davidpalma666/FED3-tester-FORK/PCB/FED3 tester.txt

OEPS020129	SMD 0603 48.7Ω ±1% 0.100W
OEPS020221	SMD 0805 0.5Ω ±1% 0.333W 

* * * * * * * * * * * * * * * * * * * * * * * * * * * * * * * * * * * * * * * * * * * * * * * * * * * * * * * * * * * * 
*  @6 Julho 2026

- novo OPAMP ZXCT199xA2	G=100
simulações feitas em Spice

Vload=3.7V
Iload=100uA => medir corrente em valor ADC <1.1V
Iload= 8.80mA => medir corrente em valor ADC <1.1V
Iload=500mA => FED3 em trabalho normal(?); não necessário medir corrente; garantir execuibilidade com este OPAMP

valor MáxADC=1.1V => apontar os dois valores a medir para meio escala ~500mV

Iload=100uA	=> Rsample=45R	=> Rload= 40k	 => Vout2ADC=500mv	OK		P(Rsample)=570nW escolher case

Iload=8.8ma => Rsample=0.6R => 	Rload= 420.5R	=> Vout2ADC=46uW		OK

Iload=500mA => Rload=6R			=> @ trabalhar com a Rsample=0.6R & Iload=500mA 	=> P(6R)= 188mW  escolher case => 
							Vout2ADC=3.3V saturado pela tensão alimentação	OK

* * * * * * * * * * * * * * * * * * * * * * * * * * * * * * * * * * * * * * * * * * * * * * * * * * * * * * * * * * * * 
*  @18 Junho 2026

Feitos testes centrados em Imeasure & modificados valores & topologia de circuito

- Rmeasure passou de 0.5R a 1R
- R36;37 alterado valor para garantir mais Iin em U9; novo valor 400R
- R47: corrigido valor de R47 para maior Vout qd Itest=8.8mA; novo valor 24k
- modificada topologia de ligação U9 Imeasure para com Relay K3
- R LDO U4 para 3.7V: corrigida R7

>> pontos acima modificados na board mas ainda não na BOM
- corrigir valores e gerar nova BOM
- ainda não modificar PCB

>> para Imeasure:
- Current measure U9=ZXCT1082 difícil para garantir medidas de corrente Imin=100uA a Imax=8.8mA
- solução em vista: utilizar novo I measure ZXCT199A3DW
- Filipe disse q por agora garantir a medição precisa dos 8.8mA será o mais importante

>> neste passo do projecto garantir a medição @8.8mA com precisão
- num novo passo testar & implementar novo ZXCT199A3DW... talvez

>> ToDo a seguir:
>> preparar & certificar o OK da board para passar ao Filipe para fw dvlpm
>> rever Rs alteradas - algumas terá de haver novo OEPSPN
>> prepar/procurar nova board para testes de ZXCT199A3DW

* * * * * * * * * * * * * * * * * * * * * * * * * * * * * * * * * * * * * * * * * * * * * * * * * * * * * * * * * * * * 
*  @24 Abril 2026
- sobre rev.B
	. pinout dos relais mal desenhado
	. R de buzzer muito grande; Rbuzzer=1r
	
- início de redesenho: FAB3 tester - rev.C

- pontos acima redesenhados e commited em Github

* * * * * * * * * * * * * * * * * * * * * * * * * * * * * * * * * * * * * * * * * * * * * * * * * * * * * * * * * * * * 
*  @11 Fevereiro 2026
>>espaçadores
	https://pt.farnell.com/harwin/r30-1611200/standoff-nylon-6-6-hex-f-f-m3/dp/3755692
	https://pt.farnell.com/harwin/r30-1611300/standoff-nylon-6-6-hex-f-f-m3/dp/3755693
	https://pt.farnell.com/harwin/r30-1611200/standoff-nylon-6-6-hex-f-f-m3/dp/3755692

* * * * * * * * * * * * * * * * * * * * * * * * * * * * * * * * * * * * * * * * * * * * * * * * * * * * * * * * * * * * 
*  @16 Fevereiro 2026

- opções para pilares de Nylon 
	. entre as board FED3 tester- support & FED3 tester
	. pilares necessários de 13mm
	. refª Buuzzer: SMT-0540-S-R	Digikey: 668-1060-6-ND
	
headers ON FED3:
	1x2	OEPS070079		68001-202HLF
	1x5	OEPS070131		M20-9990546

sockets on FED3 tester
	1x2	socket
			https://www.digikey.com/en/products/detail/sullins-connector-solutions/PPTC021LFBN-RC/810142
			MPN:	PPTC021LFBN-RC
			Dgk:		S7000-ND

	1x5 female socket
		https://www.digikey.com/en/products/detail/sullins-connector-solutions/PPTC051LFBN-RC/807239
			MPN:	PPTC051LFBN-RC
			Dgk:		S6103-ND
	
	1x5 90ºmale
		https://www.digikey.com/en/products/detail/sullins-connector-solutions/PPPC051LGBN-RC/775938
		MPN:	PPPC051LGBN-RC
		Dgk:	S5480-ND

* * * * * * * * * * * * * * * * * * * * * * * * * * * * * * * * * * * * * * * * * * * * * * * * * * * * * * * * * * * * 
*  @4 Fevereiro 2026
- placas para teste a produzir
- ainda sem componentes - para avaliar inteegração mecânica

* * * * * * * * * * * * * * * * * * * * * * * * * * * * * * * * * * * * * * * * * * * * * * * * * * * * * * * * * * * * 
*  @30 Janeiro 2026

>> nova topologia para TP na placa redesenhada pelo Filipe:
	GND - Connect to GND

	ADCx - Connect to any ADC of the uC (PORTA)
		VCCRGB
		3V3
		LED-Charge
		RED_LED
		GREEN_LED
		
	D0 - Connect to any uC pin with a 1k resistor in series
		Enable
		
	D1 - Connect to any uC pin with a 1k resistor in series
			\Reset
			
	A0 - Needs a relay to switch between open and power deliver (using the 3.7V LDO with current meter *) to DUT. Also connect to any uC's ADC (PORTA). * The power meter (or two power meters) should be able to read from 0 to 1 mA and from 20 to 300 mA.
		VBat

	A1 - Power deliver directly to DUT from the USB 5V with a power meter in the way (up to 300 mA). Needs a relay to turn the power off
		VUSB

	PROG - Direct connection to programmer

	MOTOR - Direct connection to motor
	
	RELAY - Connected to a relay to Open/Close the connection between the pins

* * * * * * * * * * * * * * * * * * * * * * * * * * * * * * * * * * * * * * * * * * * * * * * * * * * * * * * * * * * * 
*  @29 Janeiro 2026

>> Revisões feitas com o Filipe
	. agulha/ponto para Enb/Dsb do Main Switch (??)
	. agulha/ponto para ler estado dos LEDs - esperar por decisão
	
	. leitura I:
		. I min agora é 800uA; próximo volume será 80uA
		. IMax 8mA
		. em causa o q está feito com ZXCT1082
			. RLoad tem q ser grande
			. foi dimensionado para Imin 800uA - qd fôr 80uA a sensibilidade será menor
			. Utilizar Relais para utilizar RLoads diferentes para os 80uA e 8mA?? Opção posta pelo Filipe
			
		. controle da VUSB c\ FET ou Relais..
			para forçar o ON-OFF... não me lembro do pq desta questão

	. arquitectura do conjunto:
		- Board-to-Case; 
			. sem componentes; sem cobre?
			. furos para arquitectura mecânica do conjunto - esta board fixa-se à caixa; parafusos M3=> furos 2.9mm; external diameter 7mm
			. furos para os separadores Verticais - o q vai garantir o espaço entre esta Board-to-Case & a TestBoard
			. furos fixação/alinhamento das Test-Sleeves junto com a TestBoard - garantir a verticalidade das agulhas
			
		- TestBoard
			. board com o circuito de teste
			. furos para passagem de chave e apertar a Board-to-Case; os mesmos M3 q acima mas com diâmetro maior (p/a cabeça chave(?))
			. furos para os separadores Verticais - os mesmos q acima
			. furos fixação/alinhamento das Test-Sleeves junto com a TestBoard - garantir a verticalidade das agulhas & soldar ao circuito teste
			
		- DUT
			. furos/pads de teste 1.5mm raio?? ou diâmetro?!
			. 

* * * * * * * * * * * * * * * * * * * * * * * * * * * * * * * * * * * * * * * * * * * * * * * * * * * * * * * * * * * * 
*  @27 Janeiro 2026
>> ainda sem nova revisão com o Filipe
- ToDos:
	. estudar sobre a implementação das sleeves e Test Probes
	. estudar sobre a integração mecânica do todo - Sleeves, agulhas e montagemmecânica do sistema
	
	. rever alocação das parts na PCB
	
	. mais um Switch para mais uma confirmação??
	
	. localização dos LEDs?
	
	. BOM - codigos coerentes
	
	. valores de R da leitura de corrente 	OK
	
	. sockets 2.54mm mais baixas para facilitar encaixe pinos
		https://www.digikey.com/en/products/detail/3m/929870-01-02-RA/1239300
		https://www.digikey.com/en/products/detail/samtec-inc/SL-102-TT-11/1105396
		https://www.digikey.com/en/products/detail/mill-max-manufacturing-corp/834-93-002-10-001000/7771172		9€ ?!?!

>> Vias and through-holes in a PCB are typically used to pass a signal from one layer to another. When these are to be used as test points, it is necessary that they are not solder-masked so that they can be easily probed.

* * * * * * * * * * * * * * * * * * * * * * * * * * * * * * * * * * * * * * * * * * * * * * * * * * * * * * * * * * * * 
*  @22 Janeiro 2026
>> revisão com o Filipe

	- socket mais alta para motor
	
	- ter maior noção da relação furo/agulha para saber exigência da agulha
		- há já dados disto doChatGPT
	
	- controle de main-switch do DUT; disponibiliar ou não VUSB no DUT
		. actuar no En/Dsb do LDO do DUT
		. haver novo TP En/Dsb na DUT
		: actuar c/ FET ou Relay
	
	- 5 switches como do Pyboard-Test
		. start
		. 2x buzzer: OK/NOK
		. 2x motor: OK/NOK
		
	- controle para header 2x1 do charger
		. implica novos test pins na FED3? 
			Não pq o produto é vendido com o header em aberto - sem jumper
		. utilizar sockets 2.54mm 1x2 na TestBoard para ligar os Pinos do DUT 
	
	- furos ~M3 para fixar a case 'onde der' - próximo cantos

	- em falta decisão sobre substituir ou não o header de programação na FED3
		. substituir por flat TP??

* * * * * * * * * * * * * * * * * * * * * * * * * * * * * * * * * * * * * * * * * * * * * * * * * * * * * * * * * * * * 
*  @20,21 Janeiro 2026

>> adicionar rail de 3.7V para 'simular' a pilha

	OEPS080129	LDO ADJ 200mA   SOT-23-6		TPS79301DBVRG4		Once stock is depleted, this product will no longer be sold at DigiKey
		temos #13
	
	OEPS080147	LDO ADJ 240mA	SOT-23-6			NJM11100F1-TE2		Available To Order		NOK
		temos #19

		>> trabalhar com 
			OEPS080129	LDO ADJ 200mA   SOT-23-6		TPS79301DBVRG4
				
				R1=(Vout/Vref-1).R2
					R2=30.1k as-ref
					Vref=1.2246V
						=> Vout=3.3V 	=> 	R1= 51k
						=> Vout=3.7V	=>	R1=60k8

>> colocar relay para comutar entre estados de Power: 	USB ou Pilha

	OEPS100001	RELAY DPDT 1A 5V RF	SMD	G6K-2F-RF-S-TR03 DC5
		temos #1
	OEPS100010	RELAY DPDT 1A 5V RF	SMD	G6K-2F-RF DC5
		temos # ??
	relays acima equivalentes; optimizados para HF; custo maior => NOK
		
	OEPS100047	RELAY DPDT 1A 5V RF	SMD	UB2-5NUN-L
		temos # ??	#0 (?)
			refª errada ?? 
			mas é o mais adequado do nosso espólio
			"NOT FOR NEW DESIGN"
		
		!!!!!!!!!!!!!!!!!!!	A TER DE ESCOLHER RELAY NOVO ?!
		
		>> 5V SPDT
		https://www.digikey.com/en/products/filter/signal-relays-up-to-2-amps/189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
		
		1. 5€	https://www.digikey.com/en/products/detail/te-connectivity-potter-brumfield-relays/1462042-7/2126947
		2. 5€	 https://www.digikey.com/en/products/detail/te-connectivity-potter-brumfield-relays/1462042-8/2126945		!!
		3. 1.3€	https://www.digikey.com/en/products/detail/cit-relay-and-switch/J1031C5VDC-15S/14002065
		4.	2.3€	https://www.digikey.com/en/products/detail/omron-electronics-inc-emc-div/G5V-1-DC5/87831

>> FET para controle do Relay
	OEPS060013	MOSFET N-CH 30V 350mA	SOT23	SMD	DMN63D8L-7
		temos # 18
			OK

* * * * * * * * * * * * * * * * * * * * * * * * * * * * * * * * * * * * * * * * * * * * * * * * * * * * * * * * * * * * 
*  @16 Janeiro 2026

>> notas de rervisão feita com o Filipe depois do desenho já feito a esta data

- alinhar diagonal inferior da Board com a do DUT - facilita a caixa final		OK

- definir o furo para o eixo para fixação da Board na caixa final - deixar furos na board para isto
- furos para fixação M3 tb board (~último passo)

- colocar socket 1x5 onde vai encaixar controle de motor
- colocar headers 1x5 onde vai encaixar o motor 						OK

- LED vermelho para sinalizar Fail
- LEDs espaçados para haver espaço de labeling

- como avaliar o teste final de I?
	:: Imin<=800uA		IMax<=8.8mA
	- na projecto DAC há circuito para beber disto??
	- ver como...

	> resolução ADC ATXMEGA32A4U = 12 bits > 4096
	LSB= Vref/4096
	
	Vref= 1V (internal)	 LSB=0.244mV
