davidpalma666/FED3-tester-FORK/(commit log)

2026-05-15 Red LED & decouplers
    - decoupler dos Switches mudados posição
    - LED vermelho & R_LED mudados valor/refª
    [FED3 tester.kicad_pcb, main core.kicad_sch, pogo pins considerations.xlsx]
2026-05-15 promenores componentes para a BOM
    [DUT.kicad_sch, FED3 tester.kicad_pcb, FED3 tester.kicad_sch, main core.kicad_sch]
2026-05-18 sync with main
    [DUT.kicad_sch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]
2026-06-12 início Rev.C
    - corrigido pinout dos relais
    - corrigido valor & MPN & OEPSPN de R13 =1R
    - feito re-routing: DRC=0
    - gerados ficheiros de produção
    - BOM actualizada
    [DUT.kicad_sch, FED3 tester BOM-additional.csv, FED3 tester BOM.csv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]
2026-07-20 para revisão ao Filipe
    [DUT.kicad_sch, FED3 tester BOM-additional.csv, FED3 tester BOM.csv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]
2026-07-21 'limpeza' de Fab layer; tunnigs em poucas tracks
    [FED3 tester.kicad_pcb]
2026-07-21 fine tunning em fab Layer; pequenas modificações em routing
    [FED3 tester.kicad_pcb]
2026-07-21 redimensionamento mecânico & ficheiros produção
    - FED3-tester & support redimensionadas mecanicamente, na zona onde ficará o ecrã de FED3
    - pequenas correcções eléctricas vistas pelo Filipe
    - gerados ficheiros de produção de acordo com "Procedure - Generate KiCAD productionfiles"
    [DUT.kicad_sch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]
